retsyx/nrf-matter-thread-ble-esd/hw/board-nRF52840/3dmodels/SW_SPST_B3U-1000P.step

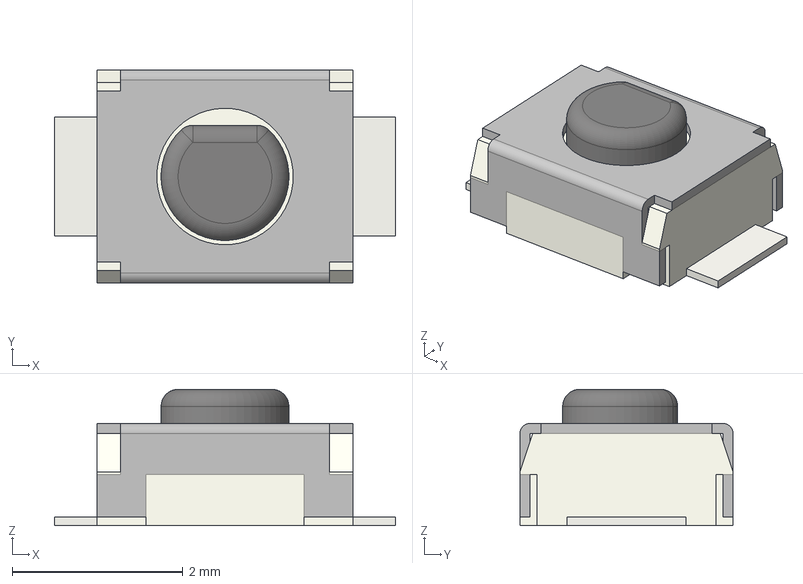
[picture p2: CAD file, 2026-10-18]
hw/board-nRF52840/3dmodels/SW_SPST_B3U-1000P.step
4.00 x 2.50 x 1.60 mm
