retsyx/nrf-matter-thread-ble-esd/hw/board-nRF52840/3dmodels/XIAO_nRF52840_bare_vendor_PCB.step

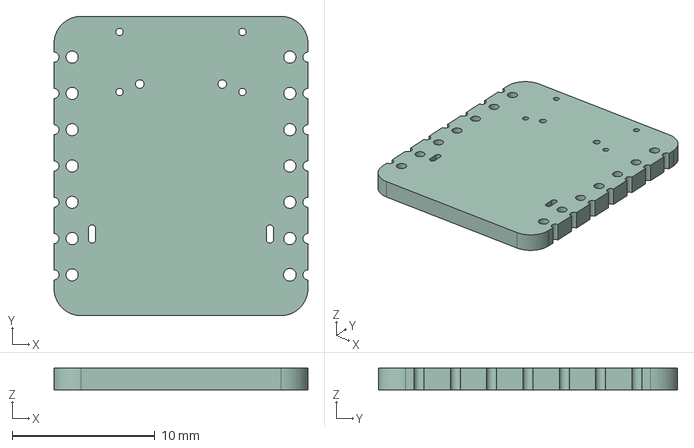
[picture p3: CAD file, 2026-10-16]
hw/board-nRF52840/3dmodels/XIAO_nRF52840_bare_vendor_PCB.step
17.8 x 21.0 x 1.51 mm
