retsyx/nrf-matter-thread-ble-esd/hw/board-nRF54L15/3dmodels/XIAO_nRF54L15_bare_vendor_PCB.step

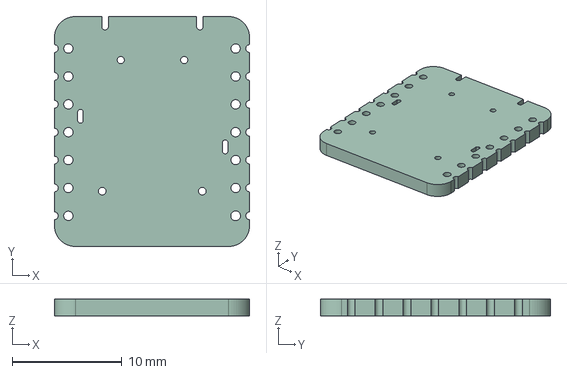
[picture p4: CAD file, 2026-10-16]
hw/board-nRF54L15/3dmodels/XIAO_nRF54L15_bare_vendor_PCB.step
17.8 x 21.0 x 1.51 mm
