retsyx/nrf-matter-thread-ble-esd/hw/board-nRF52840/3dmodels/R_0603_1608Metric.step

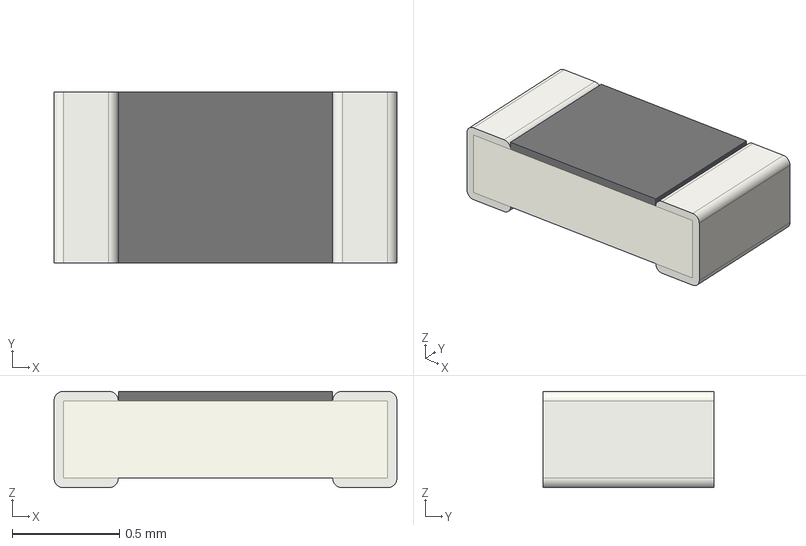
[picture p5: CAD file, 2026-10-16]
hw/board-nRF52840/3dmodels/R_0603_1608Metric.step
1.60 x 0.8 x 0.45 mm
