retsyx/nrf-matter-thread-ble-esd/hw/board-nRF54L15/3dmodels/JST_PH_S2B-PH-K_1x02_P2.00mm_Horizontal.step

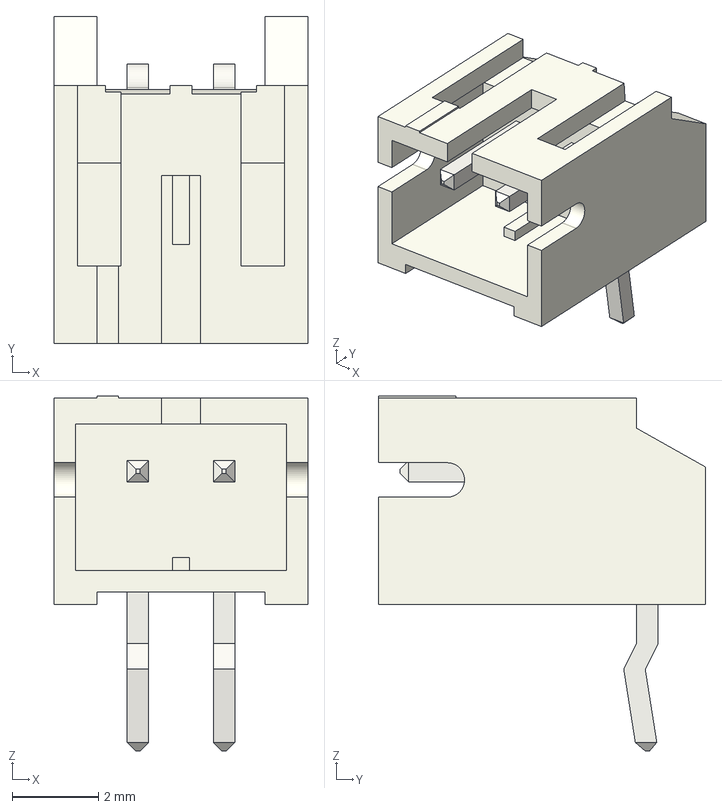
[picture p6: CAD file, 2026-10-16]
hw/board-nRF54L15/3dmodels/JST_PH_S2B-PH-K_1x02_P2.00mm_Horizontal.step
5.90 x 7.60 x 8.25 mm
