retsyx/nrf-matter-thread-ble-esd/hw/board-nRF52840/3dmodels/C_0603_1608Metric.step

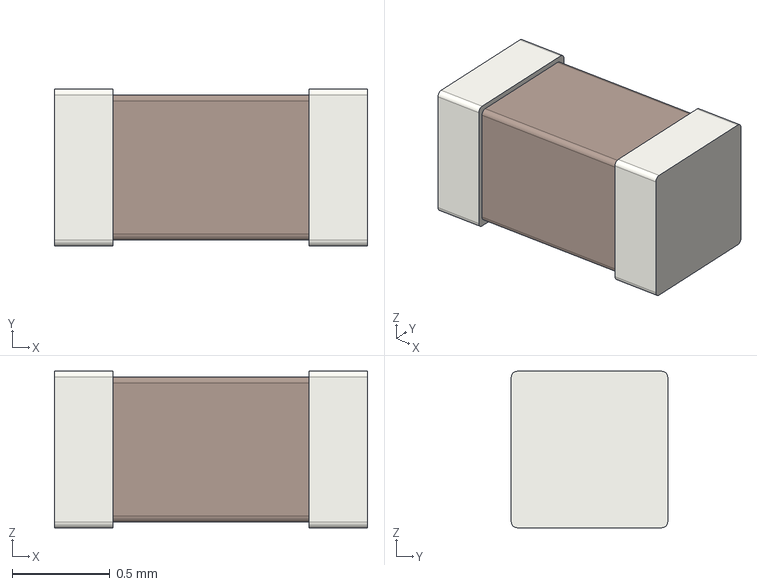
[picture p7: CAD file, 2026-10-16]
hw/board-nRF52840/3dmodels/C_0603_1608Metric.step
1.60 x 0.8 x 0.8 mm
