retsyx/nrf-matter-thread-ble-esd/hw/board-nRF54L15/3dmodels/LGA-12_2x2mm_P0.5mm.step

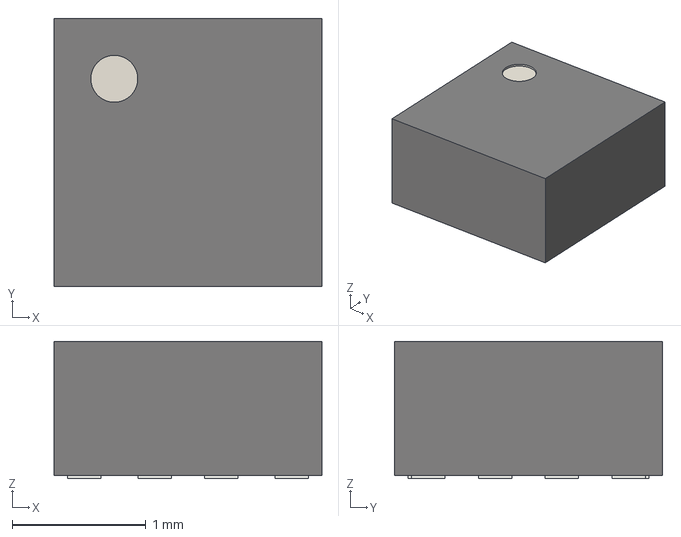
[picture p8: CAD file, 2026-10-16]
hw/board-nRF54L15/3dmodels/LGA-12_2x2mm_P0.5mm.step
2.00 x 2.00 x 1.02 mm
