retsyx/nrf-matter-thread-ble-esd/hw/board-nRF52840/board-nRF52840.kicad_pcb

## KiCad design hw/board-nRF52840/board-nRF52840.kicad_pcb (2026-10-21)

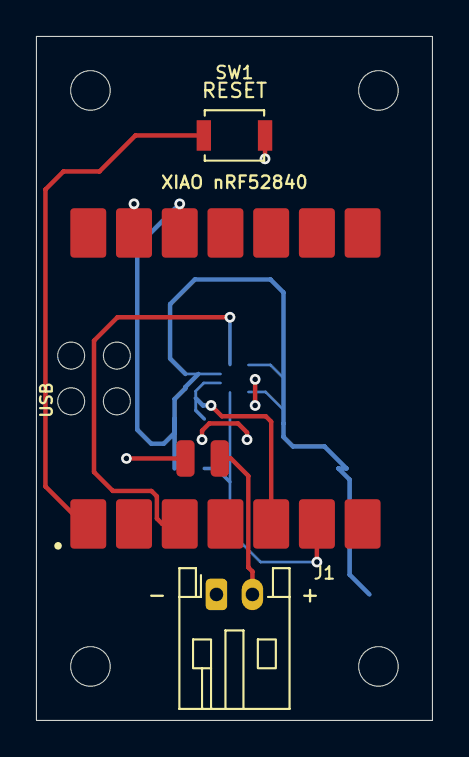
[picture p9: board board-nRF52840.kicad_pcb from above]

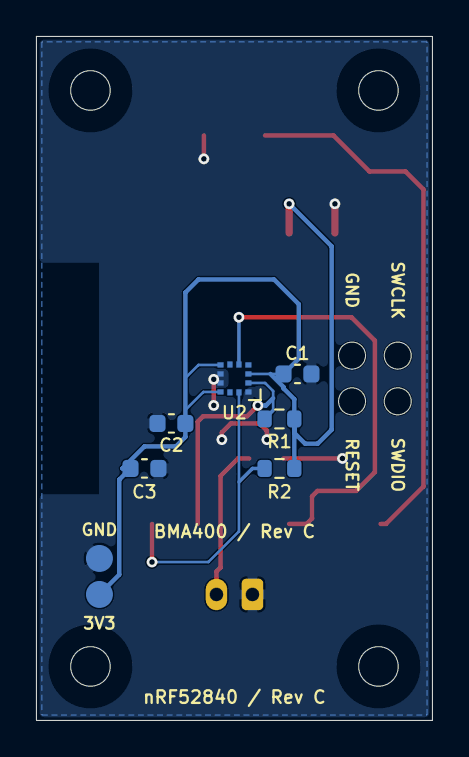
[picture p10: board board-nRF52840.kicad_pcb from below]

Board: 2 copper layers, 22.0 x 38.0 mm, 19 parts (8 on the bottom side), 7 nets.

Parts:
C1, C2: 100nF; C_0603_1608Metric
C3: 1uF; C_0603_1608Metric
H1, H2, H7, H8: MountingHole_2.2mm_M2
H3: SWDIO probe access; ProbeAccess_Hole_1.5mm
H4: SWCLK probe access; ProbeAccess_Hole_1.5mm
H5: RESET probe access; ProbeAccess_Hole_1.5mm
H6: GND probe access; ProbeAccess_Hole_1.5mm
J1: JST-PH 2.0 / BATTERY; JST_PH_S2B-PH-K_1x02_P2.00mm_Horizontal
R1, R2: 10k; R_0603_1608Metric
SW1: B3U-1000P; SW_SPST_B3U-1000P
TP1: +3V3; TestPoint_Pad_D1.5mm
TP2: GND; TestPoint_Pad_D1.5mm
U1: XIAO nRF52840; XIAO_nRF52840_SMD
U2: BMA400; LGA-12_2x2mm_P0.5mm

Connections:
/+3V3: C1.1, C2.1, C3.1, R1.1, R2.1, TP1.1, U1.12, U2.3, U2.7, U2.10
/ACC_INT1: U1.3, U2.5
/FACTORY_RESET: SW1.1, U1.1
/GND: C1.2, C2.2, C3.2, J1.1, SW1.2, TP2.1, U1.13, U1.20, U2.1, U2.8, U2.9
/I2C_SCL: R2.2, U1.6, U2.12
/I2C_SDA: R1.2, U1.5, U2.2
/VBAT: J1.2, U1.19
