retsyx/nrf-matter-thread-ble-esd/src/chip_project_config.h

// SPDX-License-Identifier: GPL-3.0-or-later
#pragma once
#define CHIP_CONFIG_SECURITY_TEST_MODE 0
#define CHIP_DEVICE_CONFIG_EVENT_LOGGING_UTC_TIMESTAMPS 1
#define CHIP_DEVICE_CONFIG_EVENT_LOGGING_DEBUG_BUFFER_SIZE 512
