retsyx/nrf-matter-thread-ble-esd/(commit log)

2026-10-18 Add factory reset button
    [SW_SPST_B3U-1000P.step, board-nRF52840.kicad_pcb, board-nRF52840.kicad_sch, board-nRF54L15.kicad_pcb, board-nRF54L15.kicad_sch]
2026-10-19 Update PCB
    [board-nRF54L15.kicad_pcb]
