retsyx/nrf-matter-thread-ble-esd/(notices)

Notices in the files:
hw/board-nRF54L15/3dmodels/R_0603_1608Metric.step:
Copyright (C) 2018, kicad StepUp
This work is licensed under the [Creative Commons CC-BY-SA 4.0 License](https://creativecommons.org/licenses/by-sa/4.0/legalcode),
with the following exception:
To the extent that the creation of electronic designs that use 'Licensed Material' can be considered to be 'Adapted Material',
You are free to use the library data in your own projects without the obligation to share your project files under this or any other license agreement.
hw/board-nRF52840/3dmodels/JST_PH_S2B-PH-K_1x02_P2.00mm_Horizontal.step:
Copyright (C) 2017, Rene Poeschl
hw/board-nRF54L15/3dmodels/C_0603_1608Metric.step:
Copyright (C) 2017, kicad StepUp
hw/board-nRF54L15/3dmodels/SW_SPST_B3U-1000P.step:
Copyright (C) 2025, KiCAD
This work is licensed under the
[Creative Commons CC-BY-SA 4.0 License](https://creativecommons.org/licenses/by-sa/4.0/legalcode),
project files under this or any other license agreement. However, if you wish to distribute
